bitfieldlabs/afterglow/afterglow_pcb_v14/afterglow_nano_smd.kicad_pcb

## KiCad design afterglow_pcb_v14/afterglow_nano_smd.kicad_pcb (2022-01-02, an earlier design)

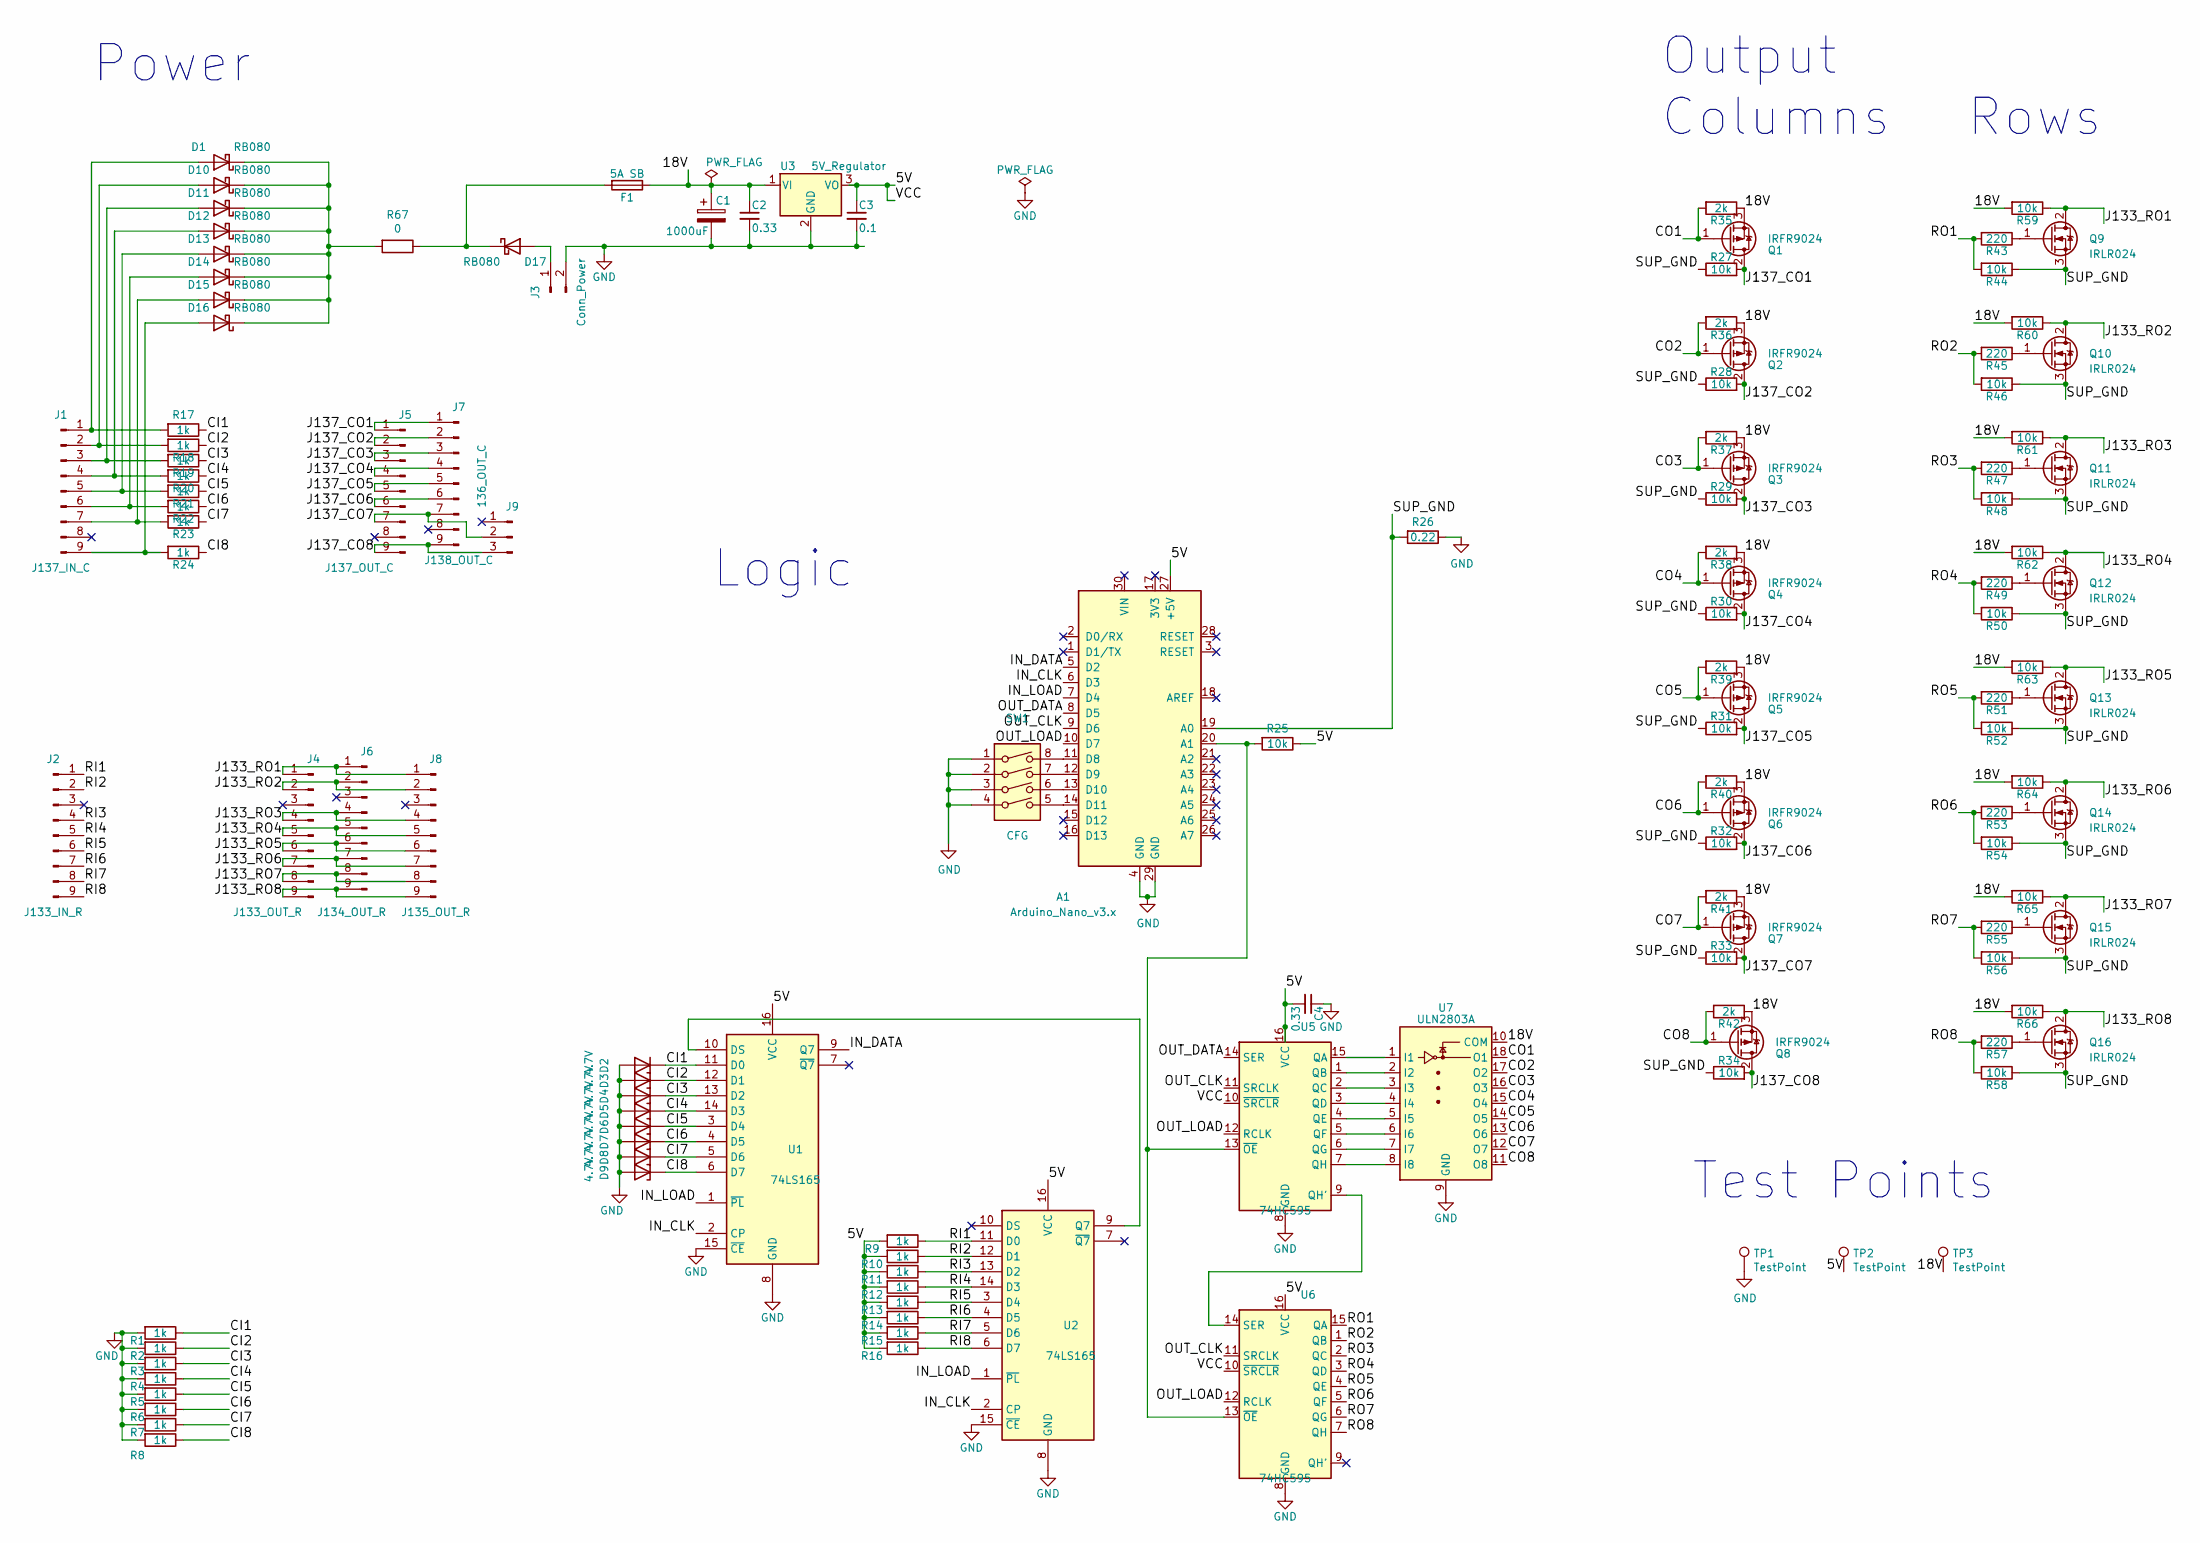
[picture p3: schematic afterglow_nano_smd.sch, afterglow]

Parts:
A1: Arduino_Nano_v3.x; Arduino_Nano
C1: 1000uF; CP_Radial_D10.0mm_P5.00mm
C2, C4: 0.33; C_0805_HandSoldering
C3: 0.1; C_0805_HandSoldering
D1, D10, D11, D12, D13, D14, D15, D16, D17: RB080; SOD-128
D2, D3, D4, D5, D6, D7, D8, D9: 4.7V; D_SOD-323_HandSoldering
F1: 5A SB; Fuseholder5x20_horiz_open_lateral_Type-II
J1: J137_IN_C; Molex_KK-41791-9_9x3.96mm_Straight
J2: J133_IN_R; Molex_KK-6410-09_09x2.54mm_Straight
J3: Conn_Power; Molex_KK-41791-02_02x3.96mm_Straight
J4: J133_OUT_R; Molex_KK-6410-09_09x2.54mm_Straight
J5: J137_OUT_C; Molex_KK-41791-9_9x3.96mm_Straight
J6: J134_OUT_R; Molex_KK-6410-09_09x2.54mm_Straight
J7: J138_OUT_C; Molex_KK-41791-9_9x3.96mm_Straight
J8: J135_OUT_R; Molex_KK-6410-09_09x2.54mm_Straight
J9: 136_OUT_C; Molex_KK-41791-03_03x3.96mm_Straight
Q1, Q2, Q3, Q4, Q5, Q6, Q7, Q8: IRFR9024; TO-252-2
Q9, Q10, Q11, Q12, Q13, Q14, Q15, Q16: IRLR024; TO-252-2
R1, R2, R3, R4, R5, R6, R7, R8, R9, R10, R11, R12, R13, R14, R15, R16, R17, R18, R19, R20, R21, R22, R23, R24: 1k; R_0805_HandSoldering
R25, R27, R28, R29, R30, R31, R32, R33, R34, R44, R46, R48, R50, R52, R54, R56, R58, R59, R60, R61, R62, R63, R64, R65, R66: 10k; R_0805_HandSoldering
R26: 0.22; R_2512_HandSoldering
R35, R36, R37, R38, R39, R40, R41, R42: 2k; R_0805_HandSoldering
R43, R45, R47, R49, R51, R53, R55, R57: 220; R_0805_HandSoldering
R67: 0; R_Axial_DIN0207_L6.3mm_D2.5mm_P2.54mm_Vertical
SW1: CFG; SW_DIP_x4_W7.62mm_Slide
TP1, TP2, TP3: TestPoint; Pin_Header_Straight_1x01_Pitch2.54mm
U1, U2: 74LS165; SOIC-16_3.9x9.9mm_Pitch1.27mm
U3: 5V_Regulator; TO-220_Vertical
U5, U6: 74HC595; SOIC-16_3.9x9.9mm_Pitch1.27mm
U7: ULN2803A; SOIC-18W_7.5x11.6mm_Pitch1.27mm

Connections:
/5V: A1.27 (+5V), C3.1, C4.2, R9.2, R10.2, R11.2, R12.2, R13.2, R14.2, R15.2, R16.2, R25.1, TP2.1, U1.16 (VCC), U2.16 (VCC), U3.3 (VO), U5.10 (~SRCLR), U5.16 (VCC), U6.10 (~SRCLR), U6.16 (VCC); also elsewhere on the board
/18V: C1.1, C2.1, F1.1, Q1.3 (S), Q2.3 (S), Q3.3 (S), Q4.3 (S), Q5.3 (S), Q6.3 (S), Q7.3 (S), Q8.3 (S), R35.1, R36.1, R37.1, R38.1, R39.1, R40.1, R41.1, R42.1, R59.2, R60.2, R61.2, R62.2, R63.2, R64.2, R65.2, R66.2, TP3.1, U3.1 (VI), U7.10 (COM); also elsewhere on the board
/CI1: D2.1 (K), R1.1, R17.1, U1.11 (D0)
/CI2: D3.1 (K), R2.1, R18.1, U1.12 (D1)
/CI3: D4.1 (K), R3.1, R19.1, U1.13 (D2)
/CI4: D5.1 (K), R4.1, R20.1, U1.14 (D3)
/CI5: D6.1 (K), R5.1, R21.1, U1.3 (D4)
/CI6: D7.1 (K), R6.1, R22.1, U1.4 (D5)
/CI7: D8.1 (K), R7.1, R23.1, U1.5 (D6)
/CI8: D9.1 (K), R8.1, R24.1, U1.6 (D7)
/CO1: Q1.1 (G), R35.2, U7.18 (O1)
/CO2: Q2.1 (G), R36.2, U7.17 (O2)
/CO3: Q3.1 (G), R37.2, U7.16 (O3)
/CO4: Q4.1 (G), R38.2, U7.15 (O4)
/CO5: Q5.1 (G), R39.2, U7.14 (O5)
/CO6: Q6.1 (G), R40.2, U7.13 (O6)
/CO7: Q7.1 (G), R41.2, U7.12 (O7)
/CO8: Q8.1 (G), R42.2, U7.11 (O8)
/IN_CLK: A1.6 (D3), U1.2 (CP), U2.2 (CP); also elsewhere on the board
/IN_DATA: A1.5 (D2), U1.9 (Q7); also elsewhere on the board
/IN_LOAD: A1.7 (D4), U1.1 (~PL), U2.1 (~PL); also elsewhere on the board
/J133_RO1: J4.1, J6.1, J8.1, Q9.2 (D), R59.1
/J133_RO2: J4.2, J6.2, J8.2, Q10.2 (D), R60.1
/J133_RO3: J4.4, J6.4, J8.4, Q11.2 (D), R61.1
/J133_RO4: J4.5, J6.5, J8.5, Q12.2 (D), R62.1
/J133_RO5: J4.6, J6.6, J8.6, Q13.2 (D), R63.1
/J133_RO6: J4.7, J6.7, J8.7, Q14.2 (D), R64.1
/J133_RO7: J4.8, J6.8, J8.8, Q15.2 (D), R65.1
/J133_RO8: J4.9, J6.9, J8.9, Q16.2 (D), R66.1
/J137_CO1: J5.1, J7.1, Q1.2 (D), R27.2
/J137_CO2: J5.2, J7.2, Q2.2 (D), R28.2
/J137_CO3: J5.3, J7.3, Q3.2 (D), R29.2
/J137_CO4: J5.4, J7.4, Q4.2 (D), R30.2
/J137_CO5: J5.5, J7.5, Q5.2 (D), R31.2
/J137_CO6: J5.6, J7.6, Q6.2 (D), R32.2
/J137_CO7: J5.7, J7.7, J9.2, Q7.2 (D), R33.2
/J137_CO8: J5.9, J7.9, J9.3, Q8.2 (D), R34.2
/OUT_CLK: A1.9 (D6), U5.11 (SRCLK), U6.11 (SRCLK); also elsewhere on the board
/OUT_DATA: A1.8 (D5), U5.14 (SER); also elsewhere on the board
/OUT_LOAD: A1.10 (D7), U5.12 (RCLK), U6.12 (RCLK); also elsewhere on the board
/RI1: J2.1, R9.1, U2.11 (D0)
/RI2: J2.2, R10.1, U2.12 (D1)
/RI3: J2.4, R11.1, U2.13 (D2)
/RI4: J2.5, R12.1, U2.14 (D3)
/RI5: J2.6, R13.1, U2.3 (D4)
/RI6: J2.7, R14.1, U2.4 (D5)
/RI7: J2.8, R15.1, U2.5 (D6)
/RI8: J2.9, R16.1, U2.6 (D7)
/RO1: R43.2, R44.2, U6.15 (QA)
/RO2: R45.2, R46.2, U6.1 (QB)
/RO3: R47.2, R48.2, U6.2 (QC)
/RO4: R49.2, R50.2, U6.3 (QD)
/RO5: R51.2, R52.2, U6.4 (QE)
/RO6: R53.2, R54.2, U6.5 (QF)
/RO7: R55.2, R56.2, U6.6 (QG)
/RO8: R57.2, R58.2, U6.7 (QH)
/SUP_GND: A1.19 (A0), Q9.3 (S), Q10.3 (S), Q11.3 (S), Q12.3 (S), Q13.3 (S), Q14.3 (S), Q15.3 (S), Q16.3 (S), R26.2, R27.1, R28.1, R29.1, R30.1, R31.1, R32.1, R33.1, R34.1, R44.1, R46.1, R48.1, R50.1, R52.1, R54.1, R56.1, R58.1; also elsewhere on the board
GND: A1.4 (GND), A1.29 (GND), C1.2, C2.2, C3.2, C4.1, D2.2 (A), D3.2 (A), D4.2 (A), D5.2 (A), D6.2 (A), D7.2 (A), D8.2 (A), D9.2 (A), J3.2, R1.2, R2.2, R3.2, R4.2, R5.2, R6.2, R7.2, R8.2, R26.1, SW1.1, SW1.2, SW1.3, SW1.4, TP1.1, U1.8 (GND), U1.15 (~CE), U2.8 (GND), U2.15 (~CE), U3.2 (GND), U5.8 (GND), U6.8 (GND), U7.9 (GND); also elsewhere on the board
unnamed 61: A1.11 (D8), SW1.8; also elsewhere on the board
unnamed 62: A1.12 (D9), SW1.7; also elsewhere on the board
unnamed 63: A1.13 (D10), SW1.6; also elsewhere on the board
unnamed 64: A1.14 (D11), SW1.5; also elsewhere on the board
unnamed 69: A1.20 (A1), R25.2, U5.13 (~OE), U6.13 (~OE); also elsewhere on the board
unnamed: D1.1 (K), D10.1 (K), D11.1 (K), D12.1 (K), D13.1 (K), D14.1 (K), D15.1 (K), D16.1 (K), R67.2
unnamed: D1.2 (A), J1.1, R17.2
unnamed: D10.2 (A), J1.2, R18.2
unnamed: D11.2 (A), J1.3, R19.2
unnamed: D12.2 (A), J1.4, R20.2
unnamed: D13.2 (A), J1.5, R21.2
unnamed: D14.2 (A), J1.6, R22.2
unnamed: D15.2 (A), J1.7, R23.2
unnamed: D16.2 (A), J1.9, R24.2
unnamed 87: D17.1 (K), F1.2, R67.1; also elsewhere on the board
unnamed: D17.2 (A), J3.1
unnamed: Q9.1 (G), R43.1
unnamed: Q10.1 (G), R45.1
unnamed: Q11.1 (G), R47.1
unnamed: Q12.1 (G), R49.1
unnamed: Q13.1 (G), R51.1
unnamed: Q14.1 (G), R53.1
unnamed: Q15.1 (G), R55.1
unnamed: Q16.1 (G), R57.1
unnamed: U1.10 (DS), U2.9 (Q7)
unnamed: U5.1 (QB), U7.2 (I2)
unnamed: U5.2 (QC), U7.3 (I3)
unnamed: U5.3 (QD), U7.4 (I4)
unnamed: U5.4 (QE), U7.5 (I5)
unnamed: U5.5 (QF), U7.6 (I6)
unnamed: U5.6 (QG), U7.7 (I7)
unnamed: U5.7 (QH), U7.8 (I8)
unnamed: U5.9 (QH'), U6.14 (SER)
unnamed: U5.15 (QA), U7.1 (I1)

Notes on the sheet:
Output
Columns
Rows
Test Points
Logic
Power

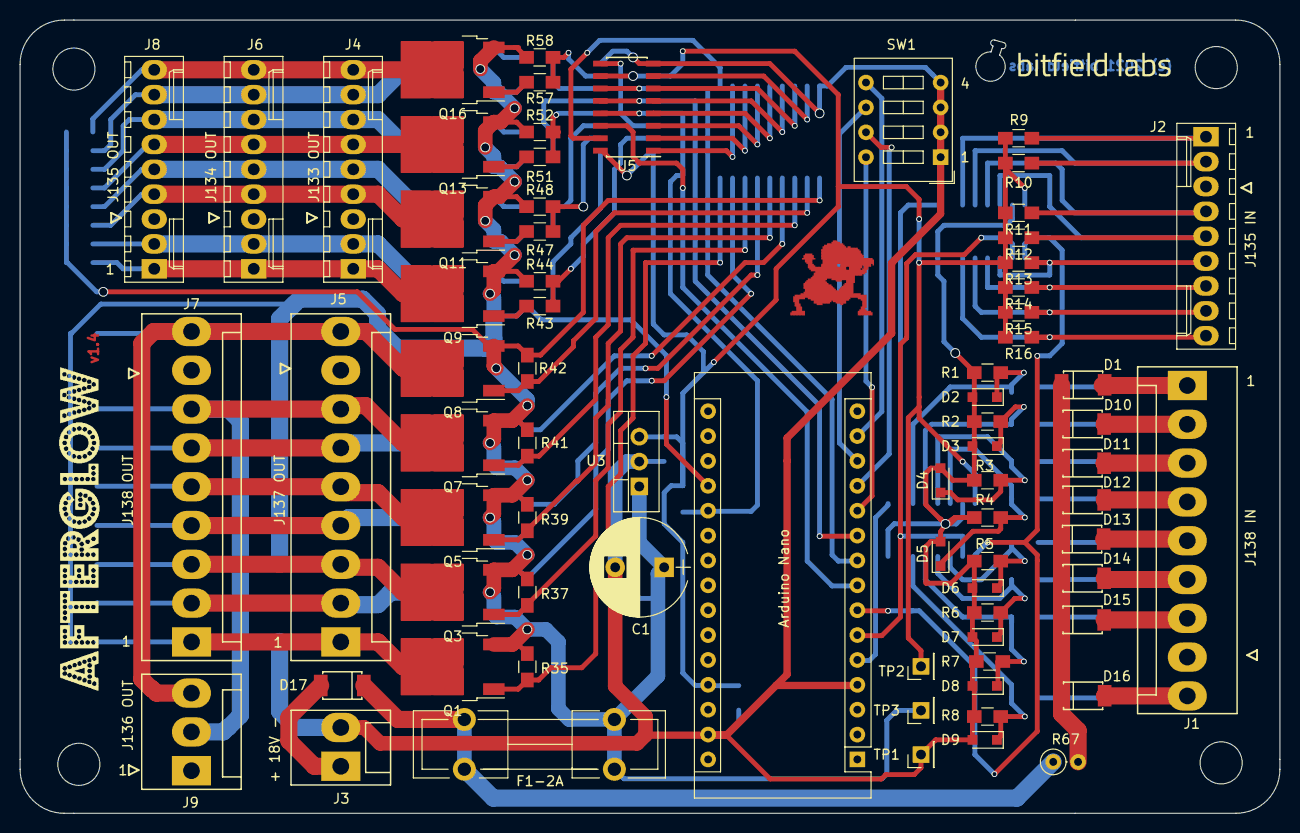
[picture p4: board afterglow_nano_smd.kicad_pcb from above]

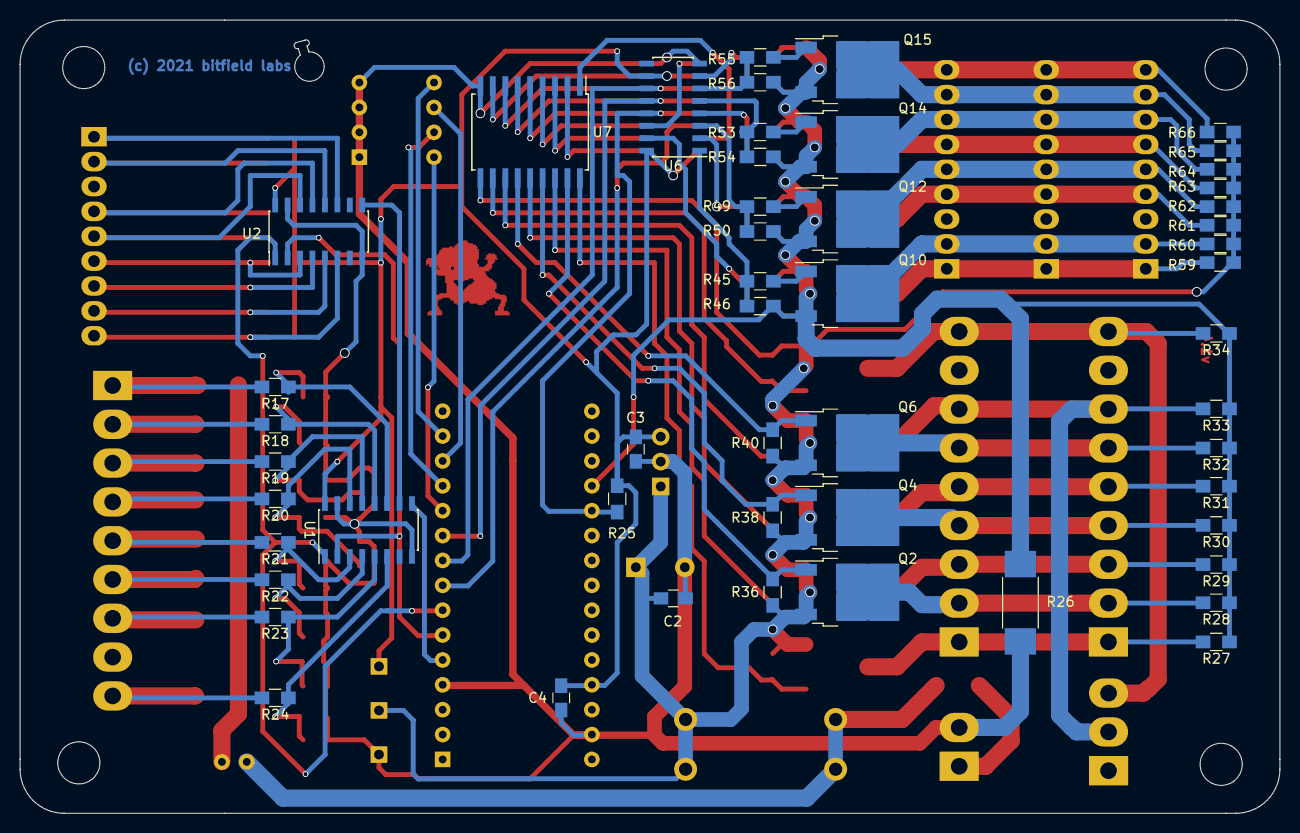
[picture p5: board afterglow_nano_smd.kicad_pcb from below]

Board: 2 copper layers, 128.7 x 81.0 mm, 127 parts (51 on the bottom side), 92 nets.

Other parts of the board:
Arduino Nano: Arduino_Nano_v3.x; Arduino_Nano
F1-2A: 5A SB; Fuseholder5x20_horiz_open_lateral_Type-II
FLAKIE: FLAKIE_inv_copper
afterglow: afterglow

Their connections:
/5V: Arduino Nano.27; also elsewhere on the board
/18V: F1-2A.1; also elsewhere on the board
/IN_CLK: Arduino Nano.6; also elsewhere on the board
/IN_DATA: Arduino Nano.5; also elsewhere on the board
/IN_LOAD: Arduino Nano.7; also elsewhere on the board
/OUT_CLK: Arduino Nano.9; also elsewhere on the board
/OUT_DATA: Arduino Nano.8; also elsewhere on the board
/OUT_LOAD: Arduino Nano.10; also elsewhere on the board
/SUP_GND: Arduino Nano.19; also elsewhere on the board
GND: Arduino Nano.4, Arduino Nano.29; also elsewhere on the board
unnamed 61: Arduino Nano.11; also elsewhere on the board
unnamed 62: Arduino Nano.12; also elsewhere on the board
unnamed 63: Arduino Nano.13; also elsewhere on the board
unnamed 64: Arduino Nano.14; also elsewhere on the board
unnamed 69: Arduino Nano.20; also elsewhere on the board
unnamed 87: F1-2A.2; also elsewhere on the board
