bitfieldlabs/afterglow/afterglow_pcb_v11/afterglow_nano.kicad_pcb

## KiCad design afterglow_pcb_v11/afterglow_nano.kicad_pcb (2018-01-12, an earlier design)

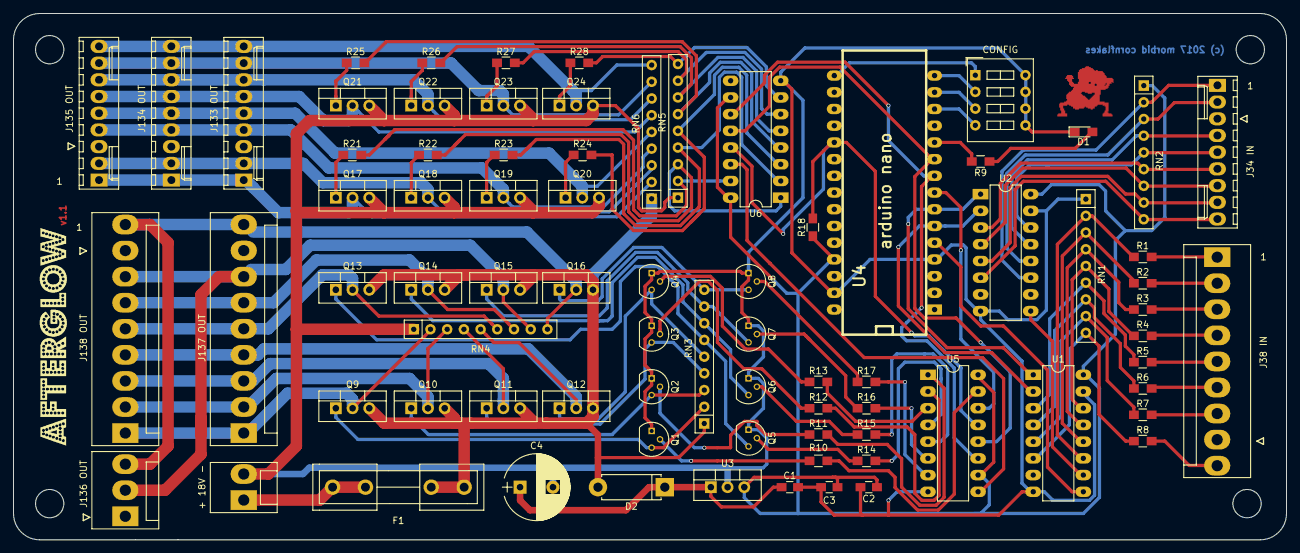
[picture p6: board afterglow_nano.kicad_pcb from above]

Board: 2 copper layers, 193.5 x 80.0 mm, 81 parts (0 on the bottom side), 100 nets.

Parts:
+ 18V -: Conn_Power; Molex_KK-41791-02_02x3.96mm_Straight
C1, C3: 0.33; C_0805_HandSoldering
C2: 0.1; C_0805_HandSoldering
C4: 1000uF; CP_Radial_D10.0mm_P5.00mm
CONFIG: CFG; SW_DIP_x4_W7.62mm_Slide
D1: LED; LED_0805_HandSoldering
D2: 1N4004; D_5W_P10.16mm_Horizontal
F1: 5A SB; Fuseholder5x20_horiz_open_inline_Type-I
FLAKIE: FLAKIE_inv_copper
J34 IN: J133_IN_R; Molex_KK-6410-09_09x2.54mm_Straight
J38 IN: J137_IN_C; Molex_KK-41791-9_9x3.96mm_Straight
J133 OUT: J133_OUT_R; Molex_KK-6410-09_09x2.54mm_Straight
J134 OUT: J134_OUT_R; Molex_KK-6410-09_09x2.54mm_Straight
J135 OUT: J135_OUT_R; Molex_KK-6410-09_09x2.54mm_Straight
J136 OUT: 136_OUT_C; Molex_KK-41791-03_03x3.96mm_Straight
J137 OUT: J137_OUT_C; Molex_KK-41791-9_9x3.96mm_Straight
J138 OUT: J138_OUT_C; Molex_KK-41791-9_9x3.96mm_Straight
Q1, Q2, Q3, Q4, Q5, Q6, Q7, Q8: 2N3904; TO-92_Molded_Narrow
Q9, Q10, Q11, Q12, Q13, Q14, Q15, Q16: FQP27P06; TO-220_Vertical
Q17, Q18, Q19, Q20, Q21, Q22, Q23, Q24: FQP30N06L; TO-220_Vertical
R1, R2, R3, R4, R5, R6, R7, R8: 1k; R_0805_HandSoldering
R9, R21, R22, R23, R24, R25, R26, R27, R28: 220; R_0805_HandSoldering
R10, R11, R12, R13, R14, R15, R16, R17, R18: 10k; R_0805_HandSoldering
RN1: 390; R_Array_SIP9
RN2, RN4, RN5, RN6: 10k; R_Array_SIP9
RN3: 2k; R_Array_SIP9
U1, U2: 74LS165; DIP-16_W7.62mm_LongPads
U3: 5V_Regulator; TO-220_Vertical
U4: arduino nano; arduino_mini
U5, U6: 74HC595; DIP-16_W7.62mm_LongPads
afterglow: afterglow

Connections:
/18V: D2.2, F1.1, Q9.3, Q10.3, Q11.3, Q12.3, Q13.3, Q14.3, Q15.3, Q16.3, RN3.1, RN6.1
/CI1: R1.1, RN1.2, U1.11
/CI2: R2.1, RN1.3, U1.12
/CI3: R3.1, RN1.4, U1.13
/CI4: R4.1, RN1.5, U1.14
/CI5: R5.1, RN1.6, U1.3
/CI6: R6.1, RN1.7, U1.4
/CI7: R7.1, RN1.8, U1.5
/CI8: R8.1, RN1.9, U1.6
/CO1: R10.2, U5.15
/CO2: R11.2, U5.1
/CO3: R12.2, U5.2
/CO4: R13.2, U5.3
/CO5: R14.2, U5.4
/CO6: R15.2, U5.5
/CO7: R16.2, U5.6
/CO8: R17.2, U5.7
/CPU1: Q1.3, Q9.1, RN3.2
/CPU2: Q2.3, Q10.1, RN3.3
/CPU3: Q3.3, Q11.1, RN3.4
/CPU4: Q4.3, Q12.1, RN3.5
/CPU5: Q5.3, Q13.1, RN3.6
/CPU6: Q6.3, Q14.1, RN3.7
/CPU7: Q7.3, Q15.1, RN3.8
/CPU8: Q8.3, Q16.1, RN3.9
/IN_CLK: U1.2, U2.2, U4.6
/IN_DATA: U1.9, U4.5
/IN_LOAD: U1.1, U2.1, U4.7
/J133_RO1: J133 OUT.1, J134 OUT.1, J135 OUT.1, Q17.2, RN6.2
/J133_RO2: J133 OUT.2, J134 OUT.2, J135 OUT.2, Q18.2, RN6.3
/J133_RO3: J133 OUT.4, J134 OUT.4, J135 OUT.4, Q19.2, RN6.4
/J133_RO4: J133 OUT.5, J134 OUT.5, J135 OUT.5, Q20.2, RN6.5
/J133_RO5: J133 OUT.6, J134 OUT.6, J135 OUT.6, Q21.2, RN6.6
/J133_RO6: J133 OUT.7, J134 OUT.7, J135 OUT.7, Q22.2, RN6.7
/J133_RO7: J133 OUT.8, J134 OUT.8, J135 OUT.8, Q23.2, RN6.8
/J133_RO8: J133 OUT.9, J134 OUT.9, J135 OUT.9, Q24.2, RN6.9
/J137_CO1: J137 OUT.1, J138 OUT.1, Q9.2, RN4.2
/J137_CO2: J137 OUT.2, J138 OUT.2, Q10.2, RN4.3
/J137_CO3: J137 OUT.3, J138 OUT.3, Q11.2, RN4.4
/J137_CO4: J137 OUT.4, J138 OUT.4, Q12.2, RN4.5
/J137_CO5: J137 OUT.5, J138 OUT.5, Q13.2, RN4.6
/J137_CO6: J137 OUT.6, J138 OUT.6, Q14.2, RN4.7
/J137_CO7: J136 OUT.2, J137 OUT.7, J138 OUT.7, Q15.2, RN4.8
/J137_CO8: J136 OUT.3, J137 OUT.9, J138 OUT.9, Q16.2, RN4.9
/OUT_CLK: U4.9, U5.11, U6.11
/OUT_DATA: U4.8, U5.14
/OUT_LOAD: U4.10, U5.12, U6.12
/RI1: J34 IN.1, RN2.2, U2.11
/RI2: J34 IN.2, RN2.3, U2.12
/RI3: J34 IN.4, RN2.4, U2.13
/RI4: J34 IN.5, RN2.5, U2.14
/RI5: J34 IN.6, RN2.6, U2.3
/RI6: J34 IN.7, RN2.7, U2.4
/RI7: J34 IN.8, RN2.8, U2.5
/RI8: J34 IN.9, RN2.9, U2.6
/RO1: R21.2, RN5.2, U6.15
/RO2: R22.2, RN5.3, U6.1
/RO3: R23.2, RN5.4, U6.2
/RO4: R24.2, RN5.5, U6.3
/RO5: R25.2, RN5.6, U6.4
/RO6: R26.2, RN5.7, U6.5
/RO7: R27.2, RN5.8, U6.6
/RO8: R28.2, RN5.9, U6.7
GND: + 18V -.2, C1.2, C2.2, C3.1, C4.2, CONFIG.5, CONFIG.6, CONFIG.7, CONFIG.8, D1.1, Q1.1, Q2.1, Q3.1, Q4.1, Q5.1, Q6.1, Q7.1, Q8.1, Q17.3, Q18.3, Q19.3, Q20.3, Q21.3, Q22.3, Q23.3, Q24.3, RN1.1, RN4.1, RN5.1, U1.8, U1.15, U2.8, U2.15, U3.2, U4.4, U4.29, U5.8, U6.8
unnamed: C1.1, C4.1, D2.1, U3.1
unnamed: D1.2, R9.1
unnamed: + 18V -.1, F1.2
unnamed: J38 IN.1, R1.2
unnamed: J38 IN.2, R2.2
unnamed: J38 IN.3, R3.2
unnamed: J38 IN.4, R4.2
unnamed: J38 IN.5, R5.2
unnamed: J38 IN.6, R6.2
unnamed: J38 IN.7, R7.2
unnamed: J38 IN.9, R8.2
unnamed: Q1.2, R10.1
unnamed: Q2.2, R11.1
unnamed: Q3.2, R12.1
unnamed: Q4.2, R13.1
unnamed: Q5.2, R14.1
unnamed: Q6.2, R15.1
unnamed: Q7.2, R16.1
unnamed: Q8.2, R17.1
unnamed: Q17.1, R21.1
unnamed: Q18.1, R22.1
unnamed: Q19.1, R23.1
unnamed: Q20.1, R24.1
unnamed: Q21.1, R25.1
unnamed: Q22.1, R26.1
unnamed: Q23.1, R27.1
unnamed: Q24.1, R28.1
unnamed: R9.2, U4.11
unnamed: R18.2, U4.20, U5.13, U6.13
unnamed: CONFIG.1, U4.16
unnamed: CONFIG.2, U4.15
unnamed: CONFIG.3, U4.14
unnamed: CONFIG.4, U4.13
unnamed: U1.10, U2.9
unnamed: U5.9, U6.14
VCC: C2.1, C3.2, R18.1, RN2.1, U1.16, U2.16, U3.3, U4.27, U5.10, U5.16, U6.10, U6.16
