bitfieldlabs/afterglow/(notices)

Notices in the files:
afterglow_pcb_v11/afterglow_nano.kicad_pcb:
(c) 2017 morbid cornflakes
afterglow_pcb_v14/afterglow_nano_smd.kicad_pcb:
(c) 2021 bitfield labs
afterglow_pcb_v13/afterglow_nano_smd.kicad_pcb:
(c) 2018 morbid cornflakes
